456789123/Fonte-Digital/Imagens/P_20200319_173014_vHDR_Auto.jpg

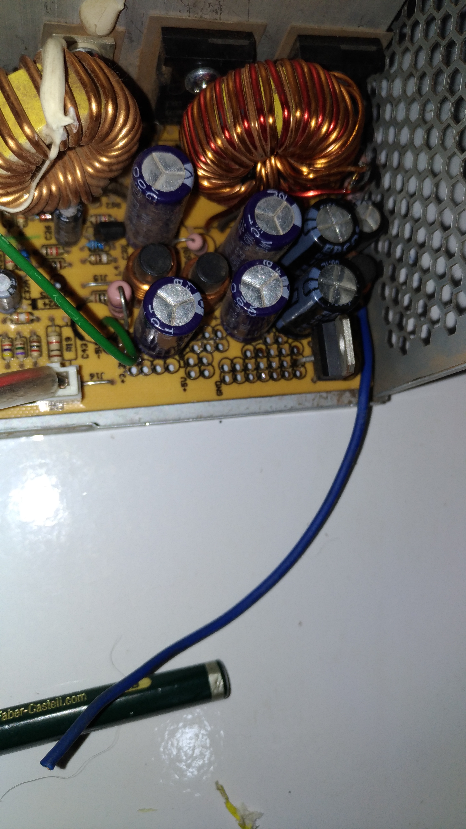
Imagens/P_20200319_173014_vHDR_Auto.jpg
