456789123/Fonte-Digital/Imagens/P_20200319_185052_vHDR_Auto.jpg

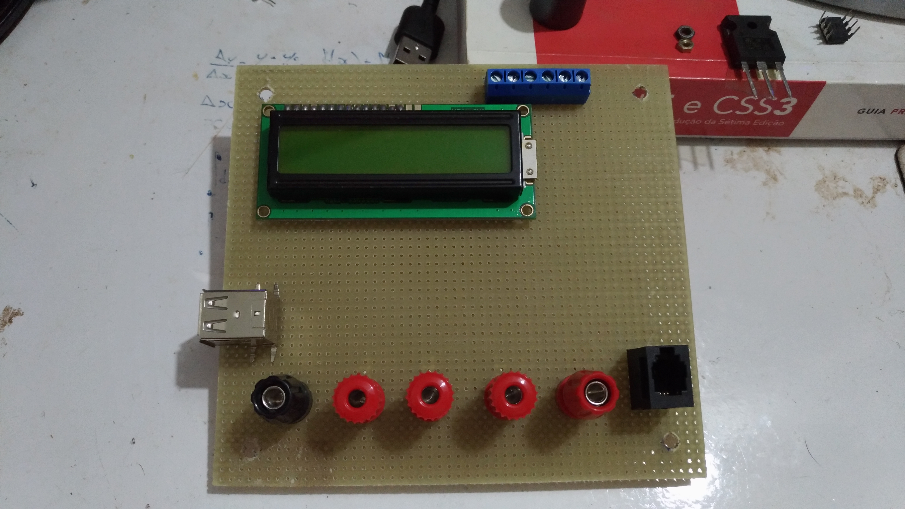
Imagens/P_20200319_185052_vHDR_Auto.jpg
