456789123/Fonte-Digital/(list of files, drawings)

Other design files:
fonte_controle.pdsprj
