456789123/Fonte-Digital/Imagens/P_20200324_085704_vHDR_Auto.jpg

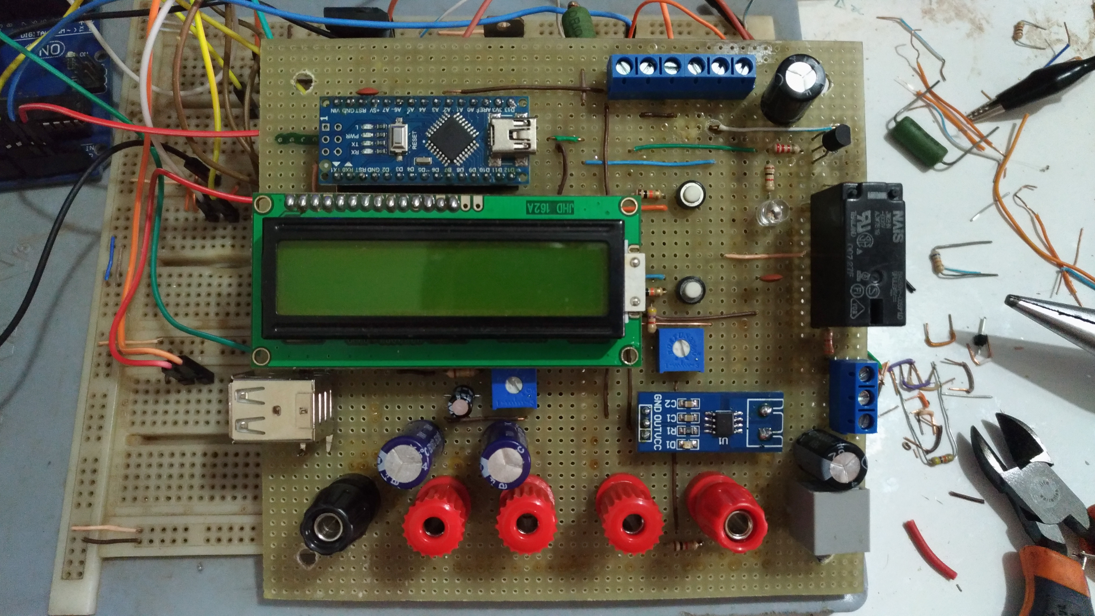
Imagens/P_20200324_085704_vHDR_Auto.jpg
