456789123/Fonte-Digital/Imagens/P_20200325_145627_vHDR_Auto.jpg

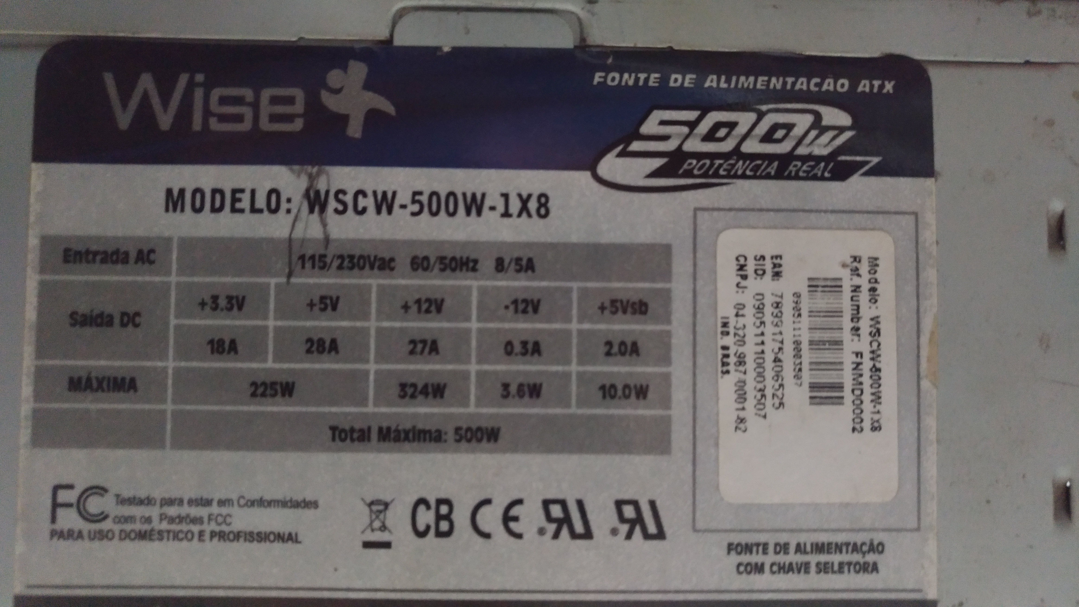
Imagens/P_20200325_145627_vHDR_Auto.jpg
