456789123/Fonte-Digital/Imagens/P_20200319_172920_vHDR_Auto.jpg

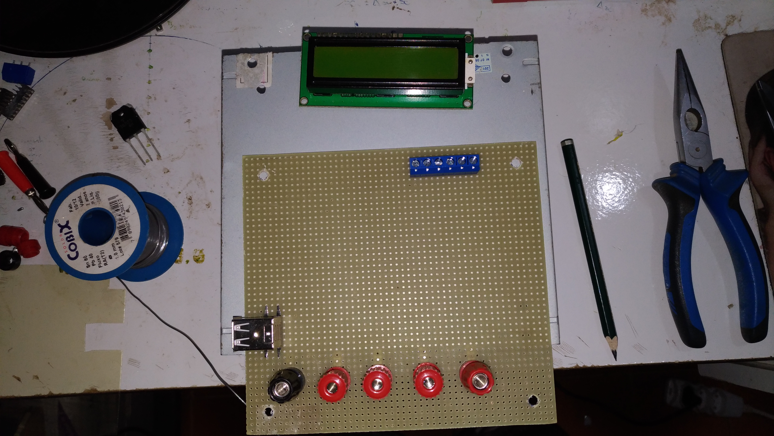
[picture p4: Imagens/P_20200319_172920_vHDR_Auto.jpg]
Imagens/P_20200319_172920_vHDR_Auto.jpg
