456789123/Fonte-Digital/Imagens/P_20200323_211239_vHDR_Auto.jpg

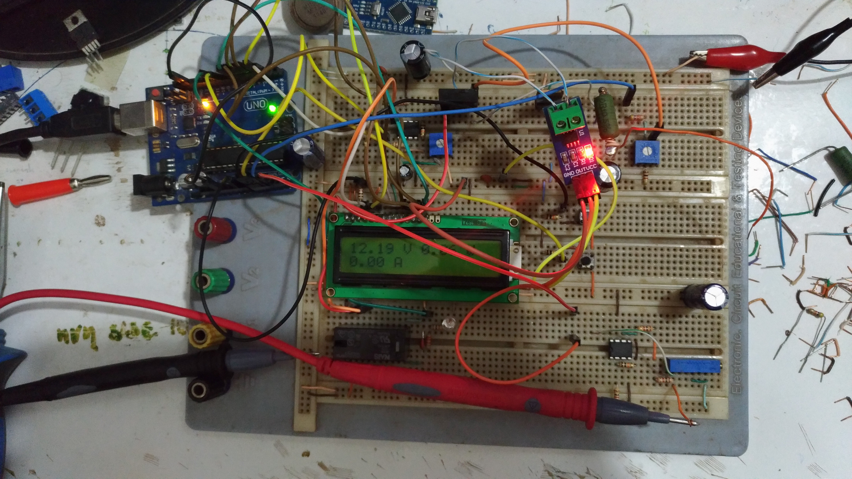
[picture p9: Imagens/P_20200323_211239_vHDR_Auto.jpg]
Imagens/P_20200323_211239_vHDR_Auto.jpg
